Abdoul-razaqYussufMbalamula/smart-ev-research-platform/motor_label.jpg

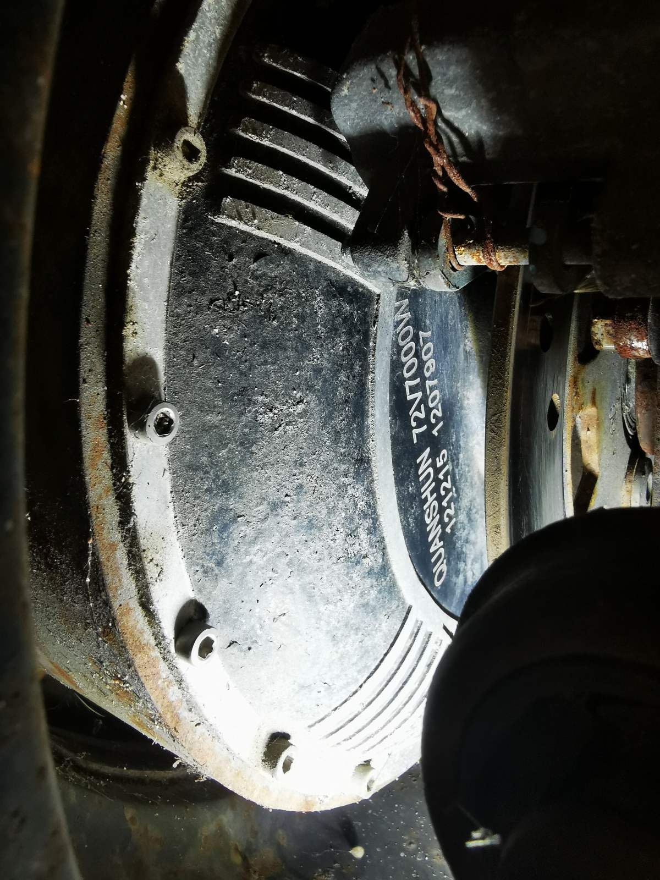
motor_label.jpg
