Abdoul-razaqYussufMbalamula/smart-ev-research-platform/hall_test_wiring.jpeg

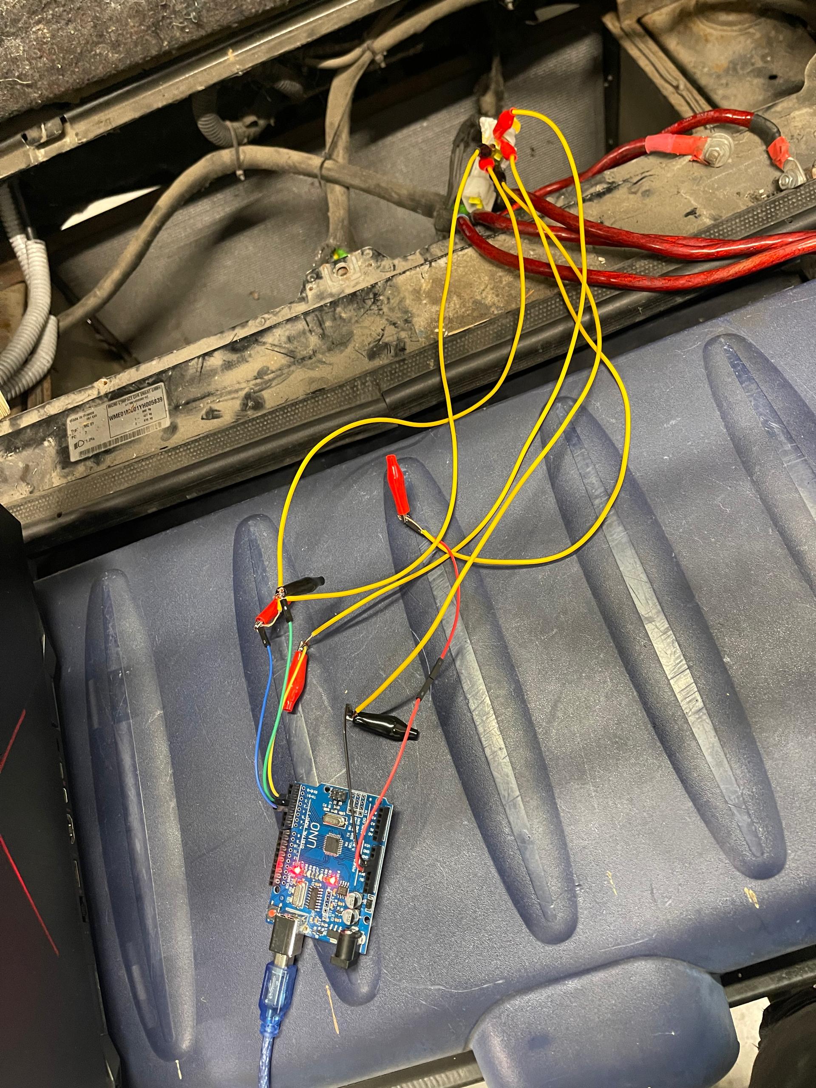
hall_test_wiring.jpeg
