Abdoul-razaqYussufMbalamula/smart-ev-research-platform/hall_test_signal_graph.jpeg

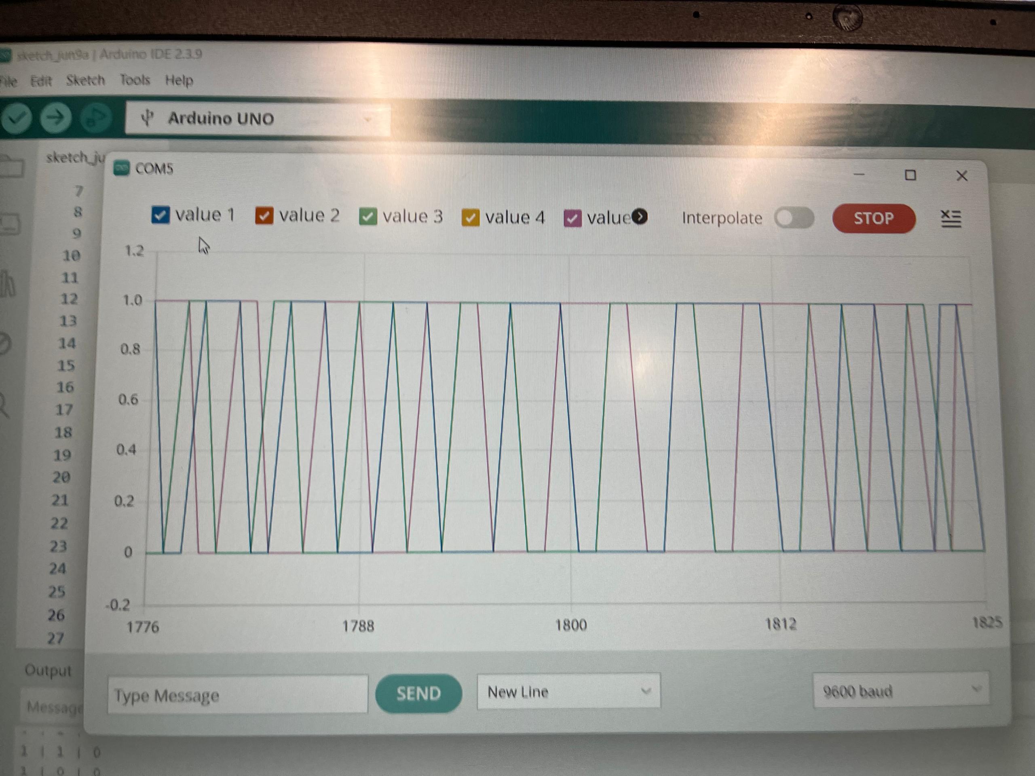
hall_test_signal_graph.jpeg
